MobiFlight/kicad-sim-panel-components/SimPanel.3dshapesSource/USB-B12-BRW.FCStd

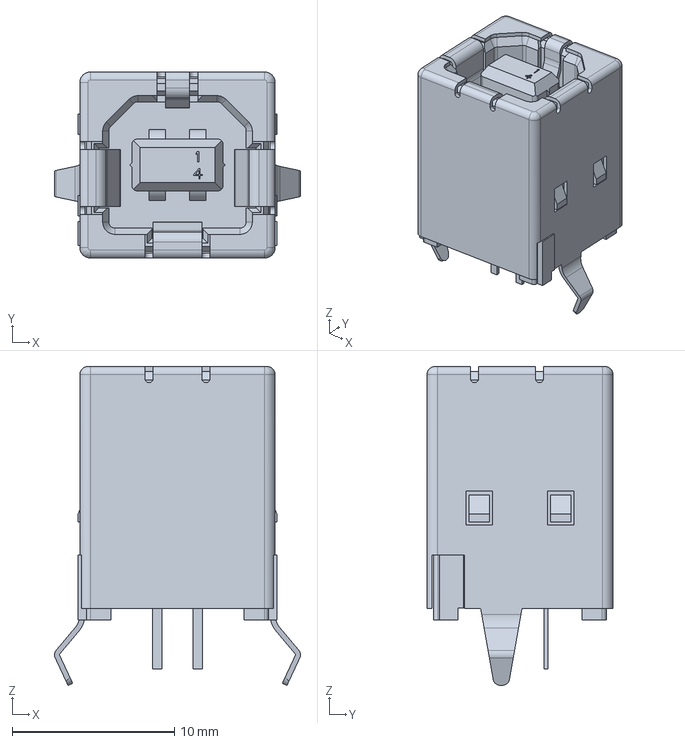
[picture p1: CAD file, 2025-07-25]
SimPanel.3dshapesSource/USB-B12-BRW.FCStd
15.1 x 11.5 x 19.6 mm
