MobiFlight/kicad-sim-panel-components/SimPanel.3dshapesSource/T80-Z1.FCStd

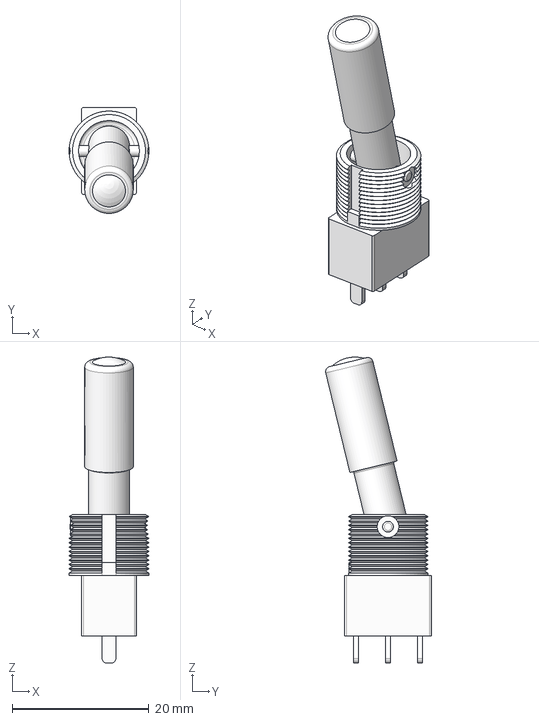
[picture p2: CAD file, 2023-12-31]
SimPanel.3dshapesSource/T80-Z1.FCStd
11.7 x 15.5 x 44.8 mm
