MobiFlight/kicad-sim-panel-components/SimPanel.3dshapesSource/KSC241JLFS.FCStd

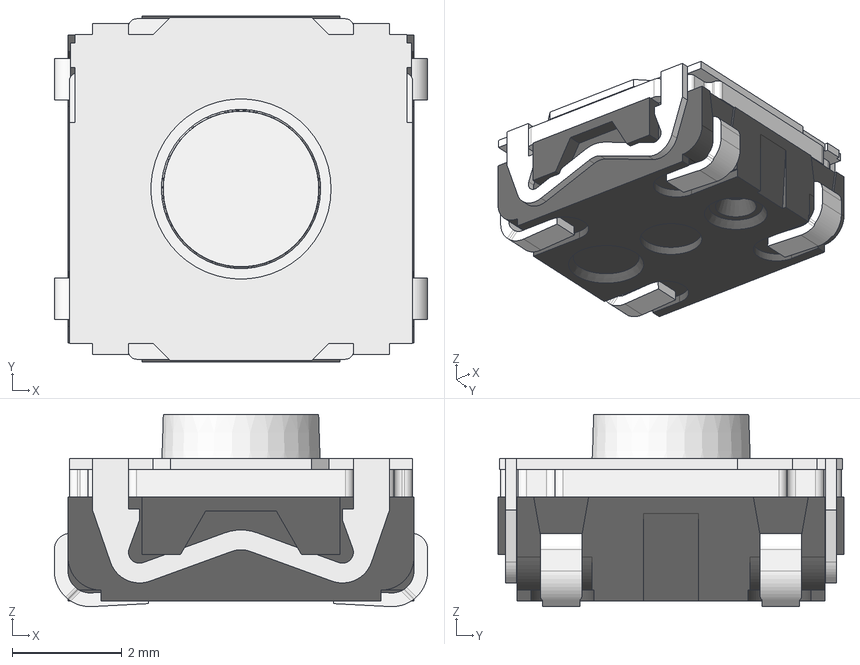
[picture p3: CAD file, 2023-11-20]
SimPanel.3dshapesSource/KSC241JLFS.FCStd
6.80 x 6.30 x 3.50 mm
KSC21J_pin
KSC21J_pin001
KSC21J_pin002
KSC21J_pin003
KSC2 - cover
KSC2 - button
KSC2 - body
