MobiFlight/kicad-sim-panel-components/SimPanel.3dshapesSource/HL-A-3528H343W-S1-13HL-HR3.FCStd

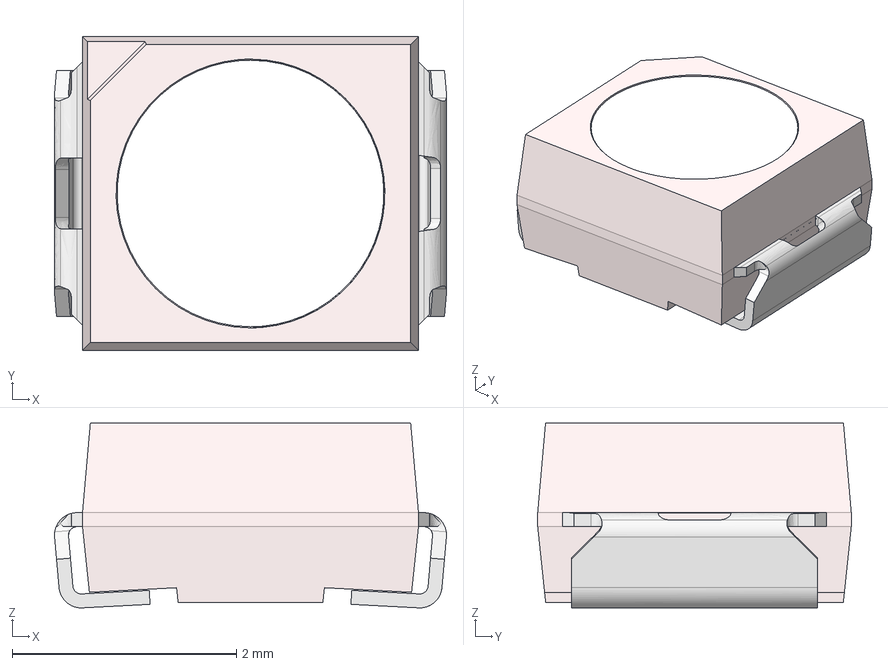
[picture p4: CAD file, 2023-08-30]
SimPanel.3dshapesSource/HL-A-3528H343W-S1-13HL-HR3.FCStd
3.50 x 2.80 x 1.65 mm
Document
Document001
Document002
Document003
