MobiFlight/kicad-sim-panel-components/(list of files, cad)

Other CAD files:
SimPanel.3dshapesSource/DICE_2281.f3d
SimPanel.3dshapesSource/DICE_2381.f3d
SimPanel.3dshapesSource/TL6275A.f3d
SimPanel.3dshapesSource/TL6275B.f3d
