MobiFlight/kicad-sim-panel-components/(threads)

Thread 16 (2023-08-31):

SN74LVC4245APWR has incorrect electrical type for OE pin

ssewell, 2023-08-31:
The SN74LVC4245APWR footprint is currently using "bidirectional" for the electrical type on the "OE" pin. Recommend setting this to "input".

Closed 2023-09-01.

Thread 20 (2023-09-01):

Add XL7219

neilenns, 2023-09-01:
Datasheet: Download from https://jlcpcb.com/partdetail/Xinluda-XL7219/C561315 (no direct link available)
Footprint: I think it's SOP-24-7.5x15.4mm_P1.27mm

neilenns, 2023-09-01:
Yes, this is a drop in replacement for the MAX7219 but this gives us a way to link the datasheet, footprint, and update one of the pin names to match the data sheet's naming :D

neilenns, 2023-09-01:
The pin rename isn't necessary since the chip specifically uses LOAD not CS. Will update.

tigert, 2024-01-25:
Hey Neil, do you plan to resurrect this? I mean its the same as MAX7219 essentially but if it comes with the part number for jlc, not the worst idea. Have you tested this chip btw if it works ok?

neilenns, 2024-01-25:
I'd forgotten this was assigned to me. No, no plans to do this :)

tigert, 2024-01-26:
ok closing, thx

Closed 2024-01-26.
