MobiFlight/kicad-sim-panel-components/(commit log)

2023-08-19 Add 2381AW symbol and footprint
2023-08-20 Add 2281AW symbol, footprint, and 3D model
2023-08-20 Add KiCad library utils for future automation of KLC compliance
2023-08-20 Create kicad-klc-check.yml
    Create GitHub action to check KiCad Library Convention (KLC) compliance.
2023-08-20 Change footprint to test KLC compliance test
2023-08-20 Update KLC footprint check to report error to GitHub action if warnings are found
2023-08-20 Fix silkscreen width that was broken for testing purposes
2023-08-20 Generalize DICE footprints for 7-segment LEDs
2023-08-21 Add TL6275 (Switch-LED combo) including "A" and "B" actuator footprint variants.
2023-08-22 Update license to align with KiCad libraries
2023-08-24 Added the Alps EC11 series dual encoder. (#1)
    * Added the Alps EC11 series dual encoder.
    Special thanks to Mark_Alpha for creating the 3D model
    * Add reference to KLC S2.2 in contributing docs
    * added missing footprint filter to the dual encoder
    * added keywords
    * moved the symbol to center
    * thickened outline (kicad symbol rules)
    * updated more kicad library rules,
    mostly text sizes
    * corrected a typo in line wifth that caused weirdness
    * added courtyard rectangle
    * stroke on silkscreen figures to 0.12mm per guidelines
    * fabrication layer figures should be 0.1mm
    * Renamed the 3d model of dual encoder to match footprint name EC11EBB24C03
    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
2023-08-24 Contributing guidelines 20230822 (#3)
    * Add links to KLC rules cited in contributing guidelines
    * Note that source files for 3D models are to be included
    * Add source files for 3D models
    [DICE_2281.f3d, DICE_2381.f3d, TL6275A.f3d, TL6275B.f3d]
2023-08-29 Added my backlight LED
    [LED_PLCC_2835.FCStd]
2023-08-29 Fix pads for EC11EBB24C03 footprint (#5)
    * Remove superfluous python cache folders
    * Fix pads for EC11EBB24C03 footprint
2023-08-29 Remove Arduino Pro Micro symbol (still WIP) (#6)
2023-08-29 Removed LED_SMD* filter since the symbol itself doesnt match it
2023-08-29 added backlight led symbol and footprint
    [LED_PLCC-2.FCStd]
2023-08-29 added the symbol for the backlight led
2023-08-29 rename and field edit frenzy
    [HL-A-3528H343W-S1-13HL-HR3.FCStd, LED_PLCC_2835.FCStd]
2023-08-29 added the KSC241JLFS basic button smd switch
    [KSC241JLFS.FCStd]
2023-09-01 Set OE pin on SN74LVC4245APWR to input Fixes #16
2023-11-19 Fixed lib checker errors hopefully for the KSC button
    [KSC241JLFS.FCStd]
2023-12-31 Added T80-Z1 series toggle switch (the big handle one)
    [T80-Z1.FCStd]
2023-12-31 renamed the footprint to be consistent
2023-12-31 updated footprint filter, actually use the correct footprint
2024-01-02 fix footprint name for backlight led symbol
2024-01-02 fix footprint filter
2024-01-04 gah, edited footprint filter
2024-01-13 split silkcreen image in parts to avoid overlapping the solder pads
2024-03-21 20240317-kav-simulations-klc-adjustments (#30)
    * Update KLC checks for KiCad 8
    * Remove superfluous S5.1 check
    * Update SimPanel footprints and symbols for KLC compliance in KiCad 8
    * Update Kav Simulations symbols for KLC compliance in KiCad 8
    * Update Kav Simulations footprints for KLC compliance in KiCad 8
2024-03-21 Update readme to note KiCad 8
2024-03-21 Update DICE footprints to note common cathode
2024-04-01 C516296 led footprint to match datasheet better (#32)
2024-06-26 Fix pitch used in footprint filter for TLC59282 symbol
2025-07-25 added vertical full size usb B connector
2025-07-25 updated line widths to match 0.1mm
2025-07-25 lines back to 0.12mm, align coutryard to grid
2025-07-25 updated 7-segment courtyards so they dont overlap when placed in 2.54mm grid
